Neyzoter/Stress-Monitor-Based-on-NB-IoT/OpensourcePCB/STM32L152/PCB_Project2.PDF

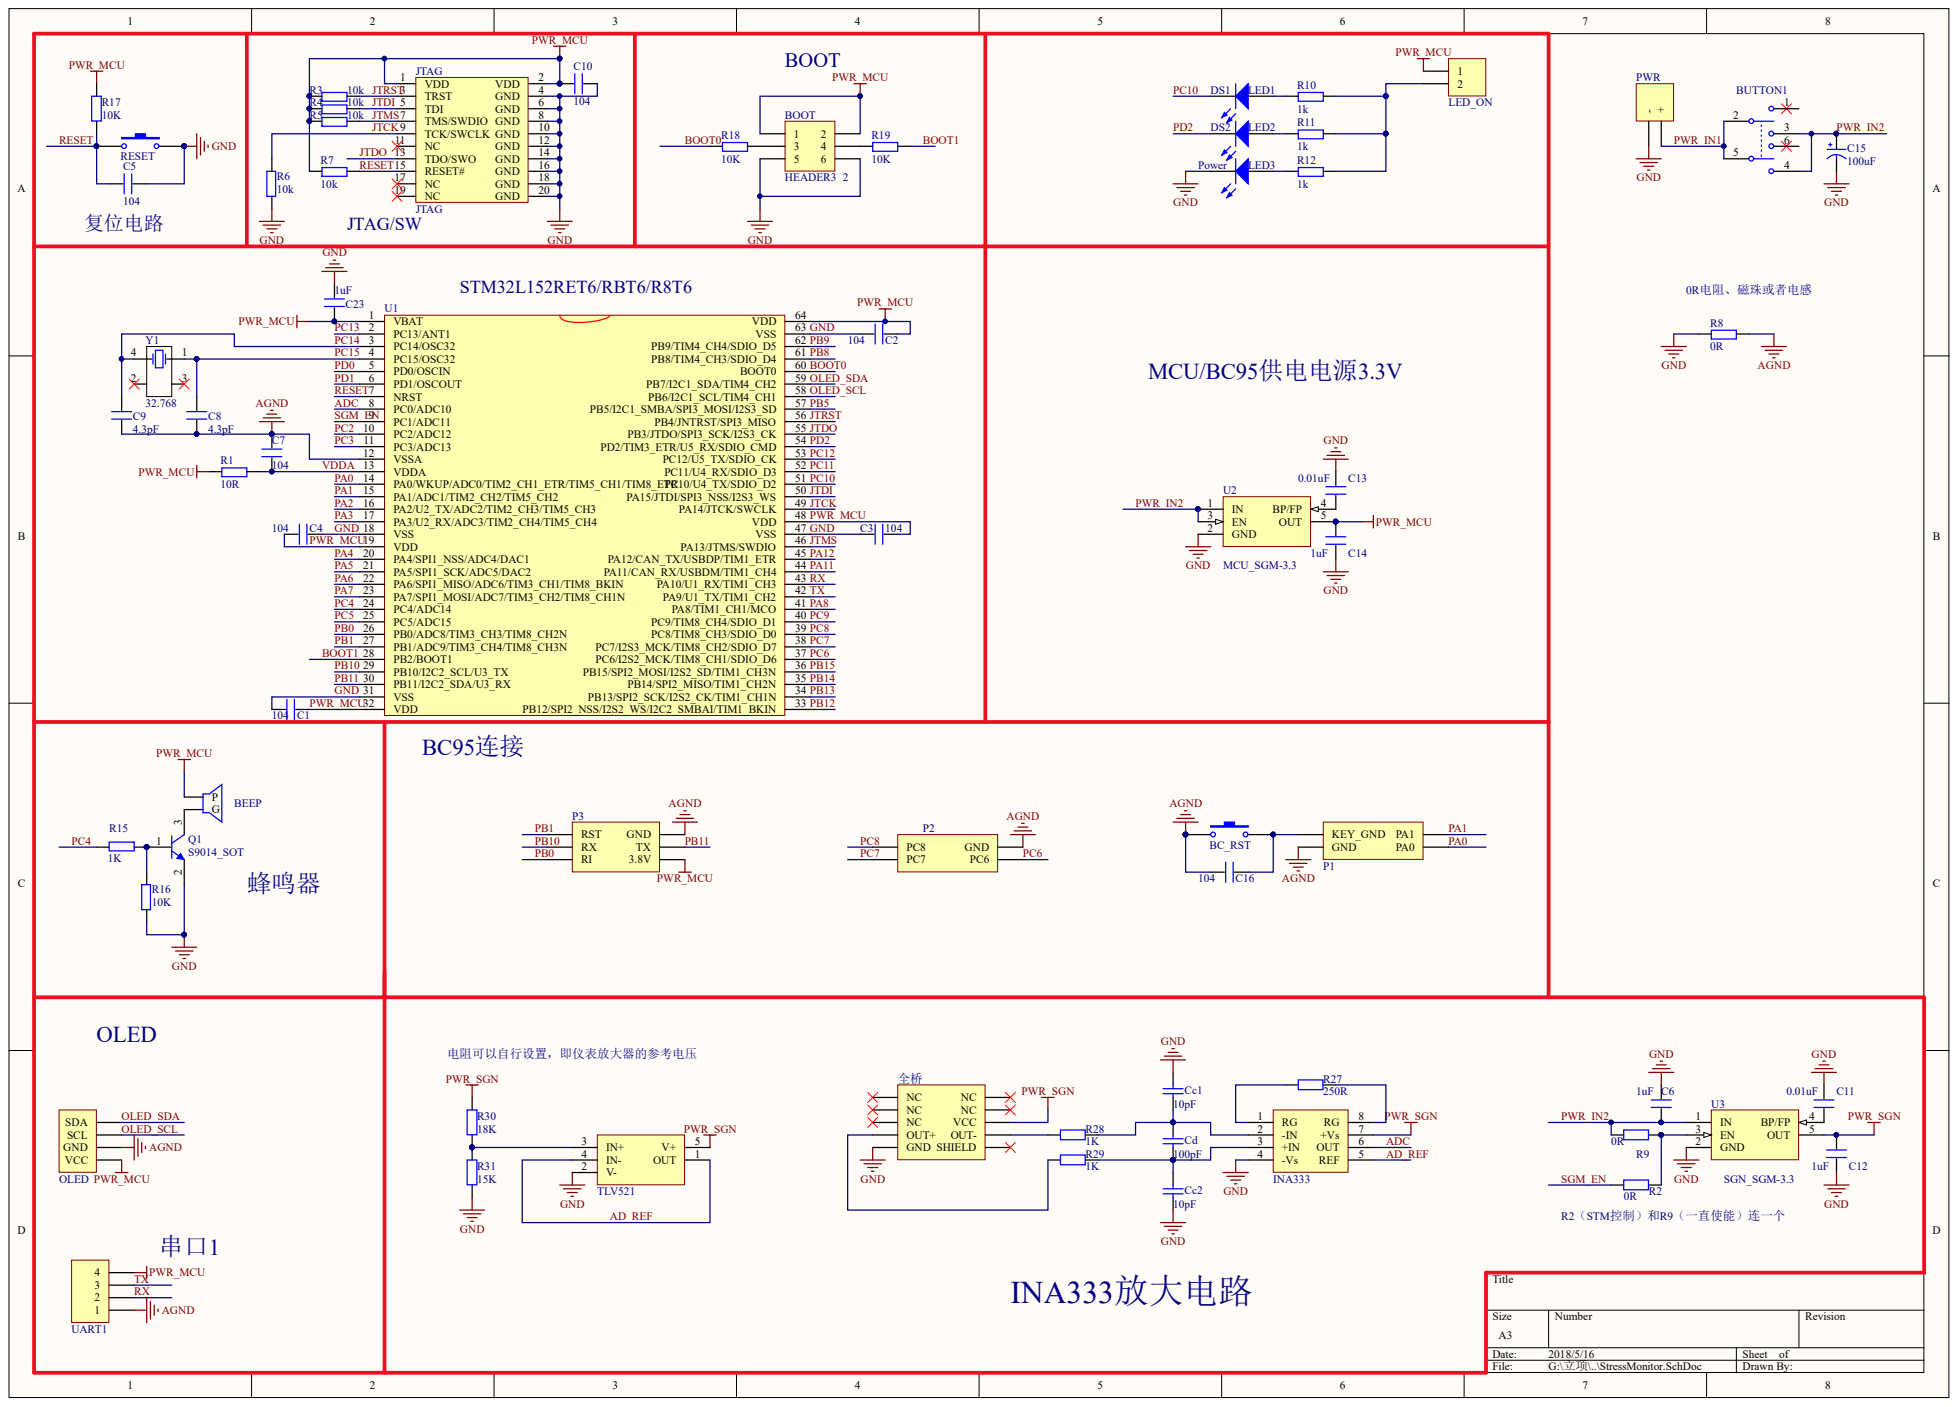
[picture p1: page 1]

PC13 | PC13/ANT1 2 | | GND

Y1 PC14 | | PC14/OSC32 3 | PB9 OLED_SDA OLED_SCL PWR_MCU

PC15/OSC32 4 | PB8

104 VDDA | VDDA 13 | PC11

VSSA 12 | PC12

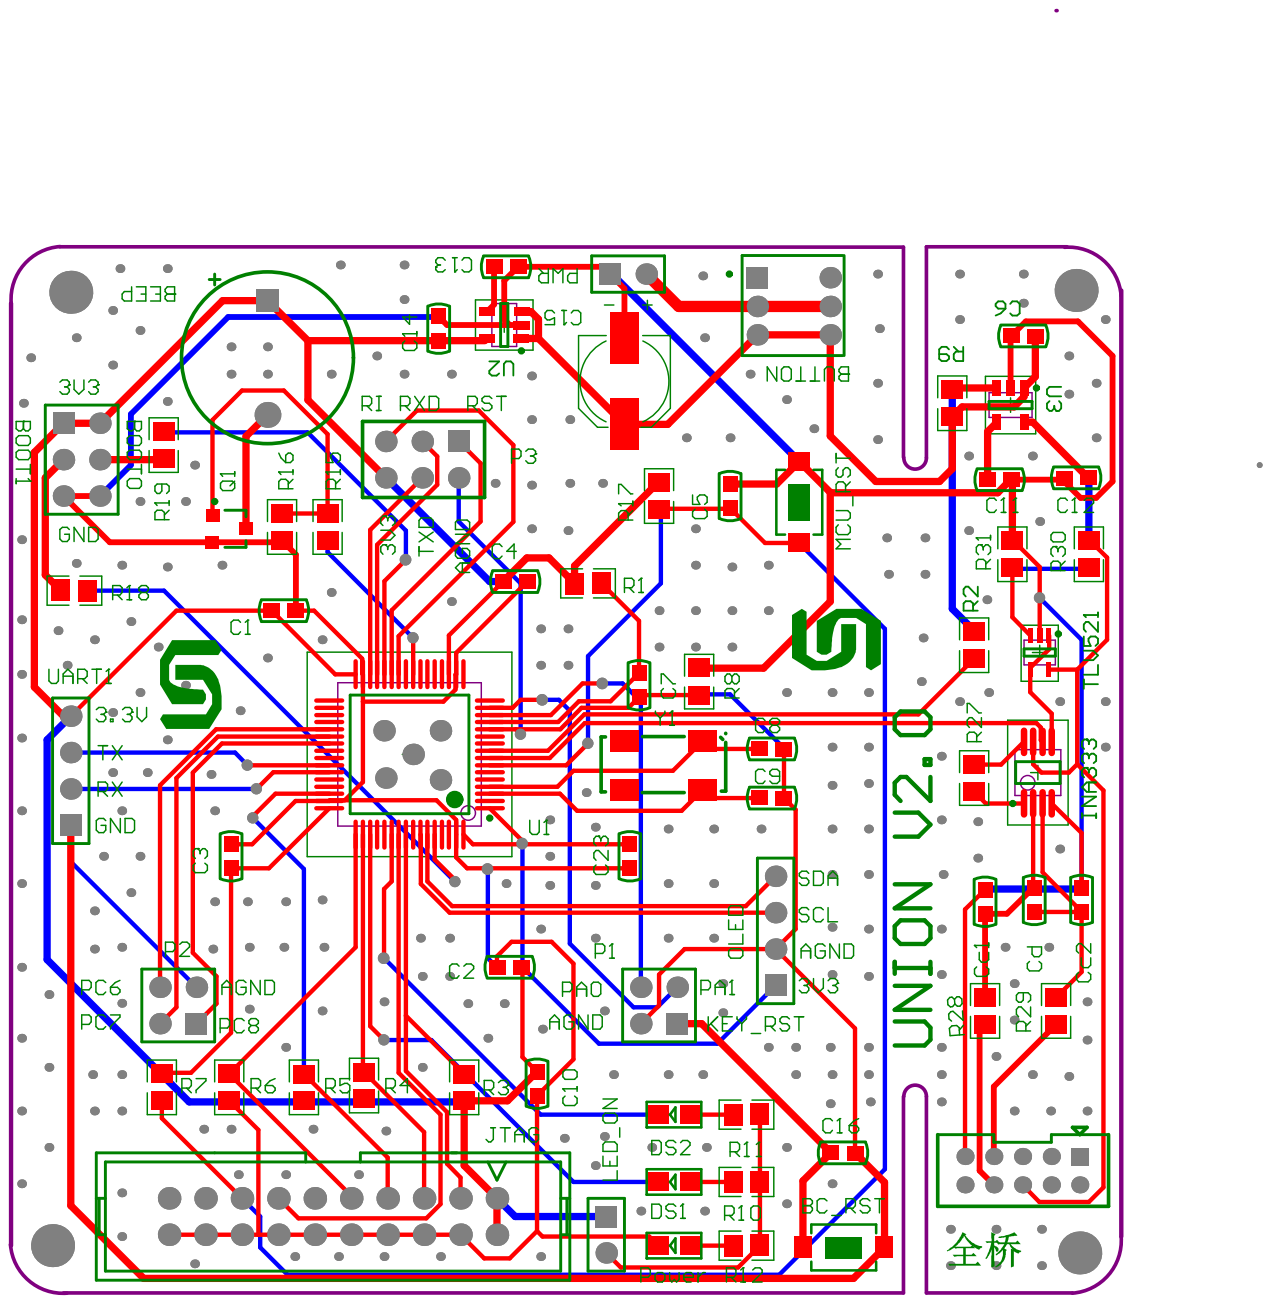
[picture p2: page 2]
