Neyzoter/Stress-Monitor-Based-on-NB-IoT/(list of files, drawings)

Other design files:
OpensourcePCB/STM32L152/PCB_Project2.PrjPCB
OpensourcePCB/STM32L152/StressMonitor.PcbDoc
OpensourcePCB/STM32L152/StressMonitor.SchDoc
