Neyzoter/Stress-Monitor-Based-on-NB-IoT/BSP/IIC/myiic.h

/*
 * Stress Monitor Based on NB-IoT
 * 项目名称：基于NB-IoT的应力监测系统
 * 作者：宋超超
 *
 * 该代码版权归宋超超所有，请勿用于商业用途。
 * https://neyzoter.github.io/
 */
#ifndef _MYIIC_H
#define _MYIIC_H
#include "sys.h"
	
//IO方向设置
//先清零
//再设置为输入或者输出
//00：输入模式Input (reset state)
//01：通用输出模式General purpose output mode
//10：Alternate function mode
//11：模拟模式Anolog Mode
#define SDA_IN()  {GPIOB->MODER&=~(3<<(7*2));GPIOB->MODER|=0<<(7*2);}	//PB7输入模式
#define SDA_OUT() {GPIOB->MODER&=~(3<<(7*2));GPIOB->MODER|=1<<(7*2);} //PB7输出模式
//IO操作
#define IIC_SCL   PBout(6) //SCL
#define IIC_SDA   PBout(7) //SDA
#define READ_SDA  PBin(7)  //输入SDA

//IIC所有操作函数
void IIC_Init(void);                //初始化IIC的IO口				 
void IIC_Start(void);				//发送IIC开始信号
void IIC_Stop(void);	  			//发送IIC停止信号
void IIC_Send_Byte(u8 txd);			//IIC发送一个字节
u8 IIC_Read_Byte(unsigned char ack);//IIC读取一个字节
u8 IIC_Wait_Ack(void); 				//IIC等待ACK信号
void IIC_Ack(void);					//IIC发送ACK信号
void IIC_NAck(void);				//IIC不发送ACK信号

void IIC_Write_One_Byte(u8 daddr,u8 addr,u8 data);
u8 IIC_Read_One_Byte(u8 daddr,u8 addr);	 

void n_nops(u8 n);

#endif
